allesblinkt/riverbed-control/z-module/z-axis-signals.md

e# Input Signal Connectors

## Stepper Z

Pul
Dir
Limit
Gnd

## Stepper A

Pul
Dir
Limit
Gnd

## Supply

24V
GND

## Grip/Sense

VacGoc
VacEject
VacSense

Light
Gnd
5V

# Output Signal Connectors

## LED

LED+
LED-

## Limits
La
Lb
Gnd

## Stepper Z

MA+
MA-
MB+
MB-

## Stepper A

MA+
MA-
MB+
MB-

## Vacuum

BN = Switch Vacuum generation
WH = Switch Ejector pulse
BK = Sense PNP 
dazwischen Rl (Load)
BU = GND

3
31

2
6

2
3
4
4
5

4pcs with 4
2pcs with 3
1pcs with 2
1pcs with 5
1pcs with 6

http://www.reichelt.de/Wannenstecker/AKL-182-04/3/index.html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

Relay?

PFET?
FET Switching
Voltage divider
Vacuum level
PNP

BN = Switch Vacuum generation
WH = Switch Ejector pulse
BK = Sense PNP 
between those is Rl (Load)
BU = GND

# Relais

LED out
Pulse Out
Vac Out
Vac In
