allesblinkt/riverbed-control/z-module-pcb/fab/DOC.md

0.5 mm bit

25000 rpm for all tools
Feed see pcb2gcode commands...\

 pcb2gcode --metric --back z-module-pcb-B.Cu.gbr --zwork -0.1 --zsafe 1.0 --mill-feed 100 --offset 0.25 --zchange 2.0 --mill-speed 6000 --mirror-absolute

Holes with 0.7 mm drill and 1 mm endmill. 

Contour with 1.0 mm endmill. Feed 800
