allesblinkt/riverbed-control/z-module-pcb/fab/z-module-pinout.pdf

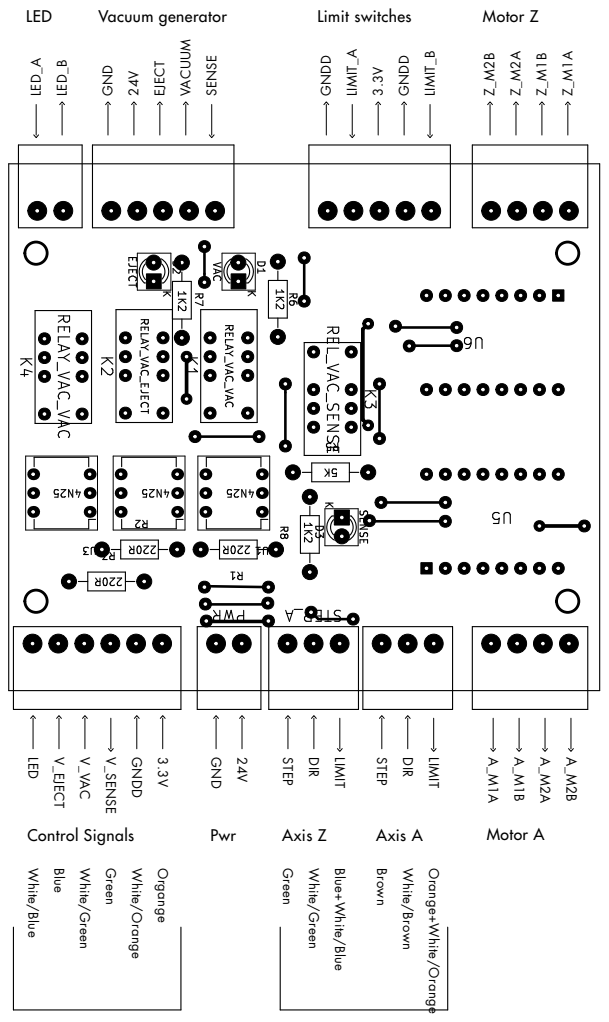
[picture p1: page 1]
LED_A; LED; Vacuum generator; Limit switches; Motor Z LED_B; GND 24V EJECT; VACUUM SENSE; GNDD LIMIT_A 3.3V GNDD LIMIT_B; Z_M²B; Z_M²A Z_M¹B; Control Signals; Motor A LED V_EJECT; V_VAC V_SENSE; GNDD 3.3V White/Blue; Blue; White/Green; Green; White/Orange; Organge; Pwr GND; Axis Z STEP; DIR; LIMIT; Axis A STEP; Brown; White/Brown

Blue+White/Blue

Orange+White/Orange
