allesblinkt/riverbed-control/z-module-pcb/z-module-pcb.pdf

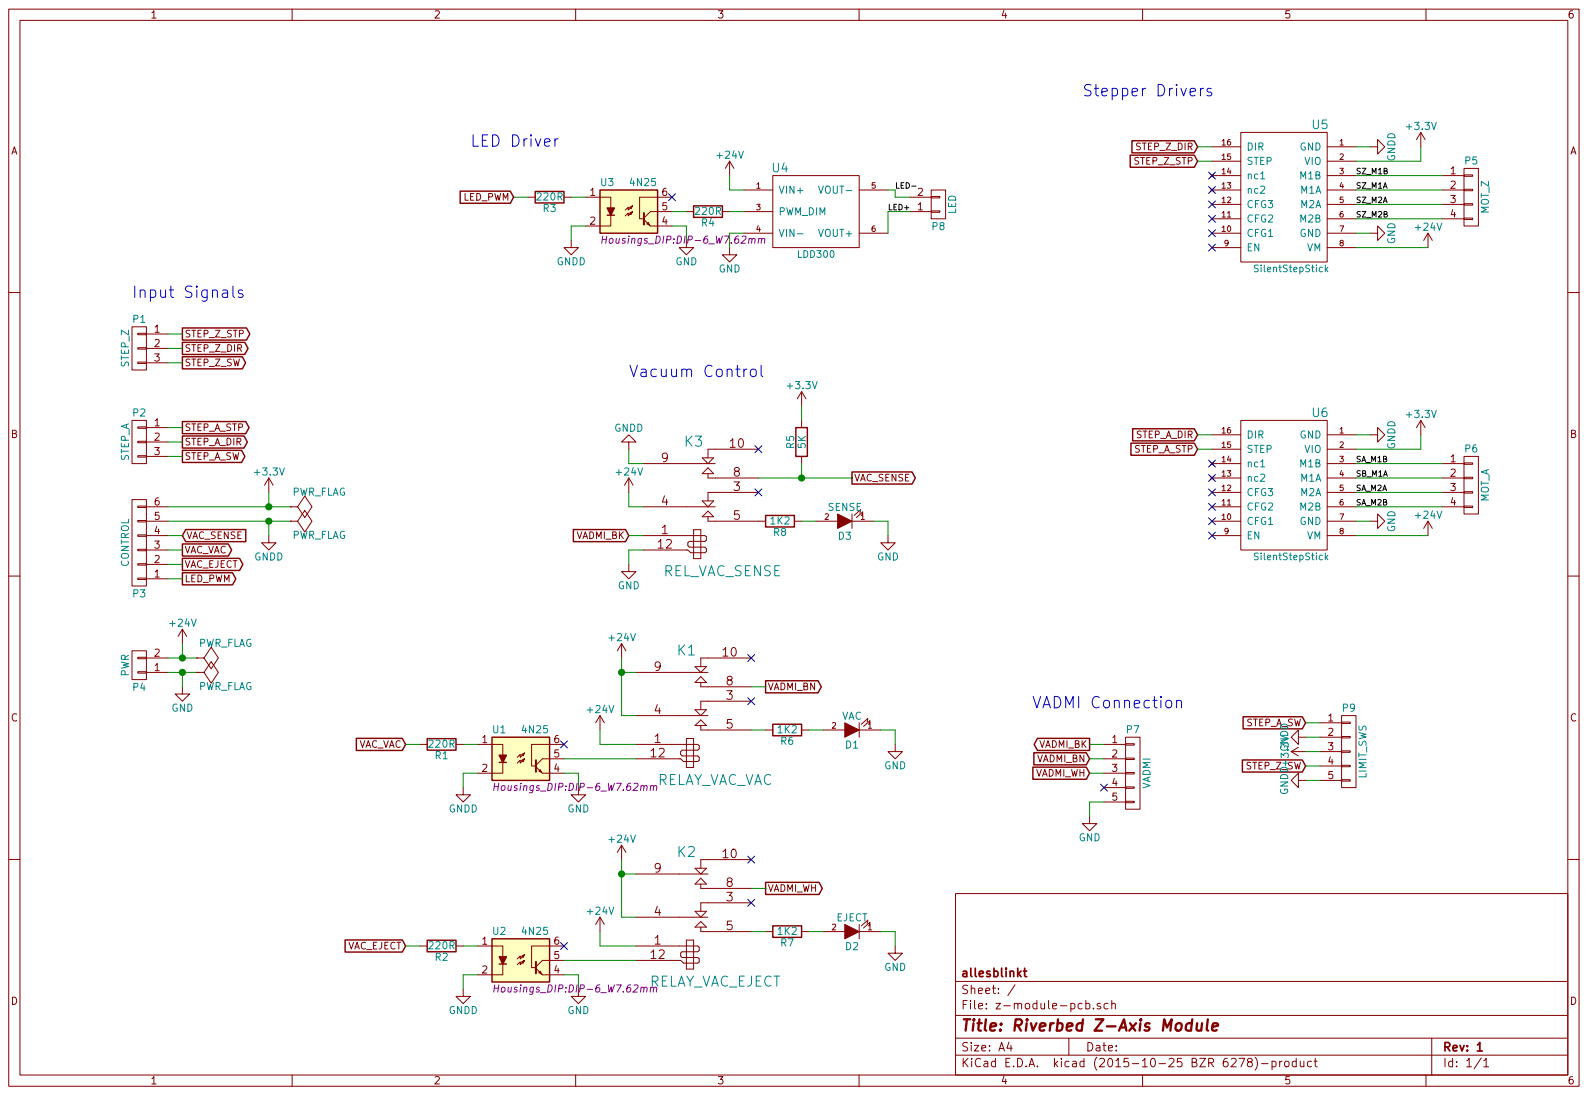
[picture p2: page 1]

SB_M1A 2
3 SA_M2A

File: z-module-pcb.sch Sheet: / allesblinkt

Id: 1/1 Title: Riverbed Z-Axis Module
