allesblinkt/riverbed-control/z-module-pcb/fab/z-module-assembly.pdf

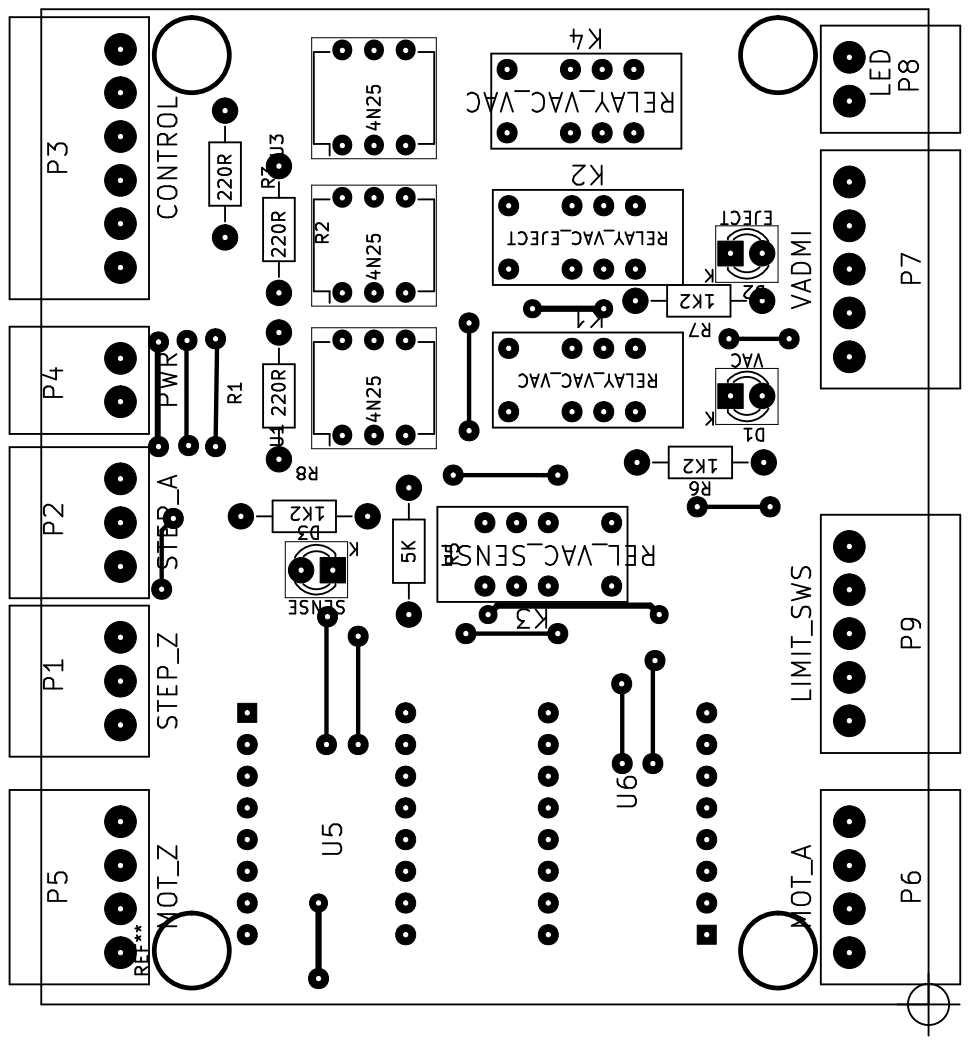
[picture p3: page 1]
