allesblinkt/riverbed-control/z-module-pcb-r2/z-module-pcb-r2.kicad_pcb

## KiCad design z-module-pcb-r2/z-module-pcb-r2.kicad_pcb (2017-08-10)

Schematic: z-module-pcb-r2.sch

Parts:
C1: 50u; CP_Radial_D7.5mm_P2.50mm
C2, C3, C4, C6, C7: 100n; C_0805
C5, C8: 20p; C_0805
D1: D_Schottky; D_SMA
D2: VacSense; LED_0805
D3: Status; LED_0805
D4: 5V; LED_0805
D5: 24V; LED_0805
D6, D8: BAT_46W; D_SOD-123
D7: Vacuum; LED_0805
D9: Eject; LED_0805
D10, D11, D12, D13, D14, D15, D16, D17, D18, D19, D20, D21, D22, D23, D24, D25, D26, D27, D28, D29: LED; LED_Osram_LW_E67C_LongPads_Thermal
F1: Rihanna; R_1812
F2: Drake; R_1812
HOLE1: 1; MountingHole_3mm
HOLE2: 2; MountingHole_3mm
HOLE3: 3; MountingHole_3mm
HOLE4: 4; MountingHole_3mm
HOLE5, HOLE6, HOLE7, HOLE8, HOLE9, HOLE10, HOLE11, HOLE12: CONN_01X01; MountingHole_2.2mm_M2
HOLE13, HOLE14: CONN_01X01; MountingHole_2.5mm
MB1, MB2, MB3, MB4, MB5, MB6, MB7, MB8, MB9, MB10, MB11, MB12, MB13, MB14, MB15, MB16, MB17, MB18, MB19, MB20: CONN_01X01; Mousebites_5_5mm_0-5mm
P1: Power; Molex_Microfit3_Header_02x02_Straight_43045-0428
P2: X1; RJ45_8-Vertical
P3: X2; RJ45_8-Vertical
P4: ISP; Pin_Header_Straight_2x03_Pitch2.54mm
P5: Z; Molex_Spox_board_4pin
P6: Vacuum; Molex_Microfit3_Header_02x04_Straight_43045-0828
P7: E; Molex_Spox_board_4pin
P8: HomeZ; Molex_Spox_board_3pin
P9: HomeE; Molex_Spox_board_3pin
P10, P18: Light; 0-188275-4_SMD_12-pin_female
P11, P12, P13, P14: 24V; Molex_PicoBlade_53048-0210_02x1.25mm_Angled
P15: 1; Molex_PicoBlade_53047-0210_02x1.25mm_Straight
P16: 2; Molex_PicoBlade_53047-0210_02x1.25mm_Straight
P17: 3; Molex_PicoBlade_53047-0210_02x1.25mm_Straight
P19: 4; Molex_PicoBlade_53047-0210_02x1.25mm_Straight
P20: 5; Molex_PicoBlade_53047-0210_02x1.25mm_Straight
P21: 6; Molex_PicoBlade_53047-0210_02x1.25mm_Straight
Q1, Q2, Q3, Q4, Q5, Q6, Q7, Q8: TSM3404_GSD; SOT-23
R1, R3, R5, R7, R9, R11, R13, R15, R17: 1K; R_0805
R2, R4, R6, R8, R10, R12, R14, R16, R18: *; R_0805
R19, R24, R26, R28, R29, R30, R31, R32, R33: 1K5; R_0805
R20, R21: 300R; R_0805
R22, R25, R27: 2K0; R_0805
R23: 10K; R_0805
R34, R35, R36, R37, R38, R39, R40, R41: 3K3; R_1206
U1: 74HC14; SOIC-14_3.9x8.7mm_Pitch1.27mm
U2, U4, U6: TLP281-4; SOIC-16_3.9x9.9mm_Pitch1.27mm
U3: 7805SR; TO-220
U5: 74HC04; SOIC-14_3.9x8.7mm_Pitch1.27mm
U7: ATMEGA328-AU; TQFP-32_7x7mm_Pitch0.8mm
Y1: Crystal_GND24; Crystal_SMD_3225-4pin_3.2x2.5mm

Connections:
+5V: C2.2, C3.2, C6.2, C7.2, F1.1, P3.8, P4.2, P8.1, P9.1, R1.1, R3.1, R5.1, R7.1, R9.1, R11.1, R13.1, R15.1, R17.1, R21.1, R23.2, U1.14 (VCC), U5.14 (VCC), U7.4 (VCC), U7.6 (VCC), U7.18 (AVCC); also elsewhere on the board
+24V: C1.1, D1.1 (K), D6.1 (K), D7.2 (A), D8.1 (K), D9.2 (A), P6.1, P6.2, P6.3, P10.2, P10.4, P10.6, P10.8, P10.10, P10.12, R22.1, U3.1 (IN); also elsewhere on the board
+28V: P15.1, P16.1, P17.1, P18.2, P18.4, P18.6, P18.8, P18.10, P18.12, P19.1, P20.1, P21.1
/AxisDriver1/M_1A: P5.3; also elsewhere on the board
/AxisDriver1/M_1B: P5.4; also elsewhere on the board
/AxisDriver1/M_2A: P5.2; also elsewhere on the board
/AxisDriver1/M_2B: P5.1; also elsewhere on the board
/AxisDriver2/M_1A: P7.3; also elsewhere on the board
/AxisDriver2/M_1B: P7.4; also elsewhere on the board
/AxisDriver2/M_2A: P7.2; also elsewhere on the board
/AxisDriver2/M_2B: P7.1; also elsewhere on the board
/CONTROL_COMM: P3.4, U4.5, U4.7, U6.1
/E_COMM: P2.8, U2.7, U4.1, U4.3
/E_DIR: U1.4; also elsewhere on the board
/E_DIR_IN: P2.6, R10.1
/E_EN: U1.2; also elsewhere on the board
/E_EN_IN: P2.7, R12.1
/E_HOME_OUT: P3.6, P9.2
/E_STEP: U1.6; also elsewhere on the board
/E_STEP_IN: P2.5, R8.1
/LED_1: P10.1, Q8.3 (D)
/LED_2: P10.3, Q7.3 (D)
/LED_3: P10.5, Q6.3 (D)
/LED_4: P10.7, Q5.3 (D)
/LED_5: P10.9, Q4.3 (D)
/LED_6: P10.11, Q3.3 (D)
/LED_A_A: P11.1, R34.2
/LED_A_K: D14.1 (K), P11.2
/LED_BO_1: P15.2, P18.1
/LED_BO_2: P16.2, P18.3
/LED_BO_3: P17.2, P18.5
/LED_BO_4: P18.7, P19.2
/LED_BO_5: P18.9, P20.2
/LED_BO_6: P18.11, P21.2
/LED_B_A: P12.1, R36.2
/LED_B_K: D19.1 (K), P12.2
/LED_C_A: P13.1, R38.2
/LED_C_K: D24.1 (K), P13.2
/LED_D_A: P14.1, R40.2
/LED_D_K: D29.1 (K), P14.2
/LIGHT_CTRL: U5.6, U7.32 ((PCINT18/INT0)PD2)
/LIGHT_CTRL_IN: P3.3, R18.1
/MISO: P4.1, U7.16 ((PCINT4/MISO)PB4)
/MOSI: P4.4, Q4.1 (G), R29.2, U7.15 ((PCINT3/OC2A/MOSI)PB3)
/PWM_LED_1: Q8.1 (G), R33.1, U7.1 ((PCINT19/OC2B/INT1)PD3)
/PWM_LED_2: Q7.1 (G), R32.1, U7.9 ((PCINT21/OC0B/T1)PD5)
/PWM_LED_3: Q6.1 (G), R31.1, U7.13 ((PCINT1/OC1A)PB1)
/PWM_LED_4: Q5.1 (G), R30.1, U7.14 ((PCINT2/OC1B/~SS~)PB2)
/PWM_LED_6: Q3.1 (G), R28.2, U7.10 ((PCINT22/OC0A/AIN0)PD6)
/RST: C4.2, P4.5, R23.1, U7.29 ((PCINT14/~RESET~)PC6)
/SCK: P4.3, U7.17 ((PCINT5/SCK)PB5)
/STATUSLED_1: R20.1, U7.12 ((PCINT0/CLKO/ICP1)PB0)
/VAC_AUX_AUX: P6.8
/VAC_BLACK_SENSE: D2.2 (A), P6.7
/VAC_BROWN_VAC: D8.2 (A), P6.6, Q2.3 (D), R25.1
/VAC_EJECT: Q1.1 (G), R24.1, U5.4
/VAC_EJECT_IN: P3.2, R16.1
/VAC_ON_IN: P3.1, R14.1
/VAC_SENSE_OUT: P3.7, U6.12
/VAC_VAC: Q2.1 (G), R26.1, U5.2
/VAC_WHITE_EJECT: D6.2 (A), P6.5, Q1.3 (D), R27.1
/XTAL1: C5.1, U7.8 ((PCINT7/XTAL2/TOSC2)PB7), Y1.1
/XTAL2: C8.1, U7.7 ((PCINT6/XTAL1/TOSC1)PB6), Y1.3
/Z_COMM: P2.4, U2.1, U2.3, U2.5
/Z_DIR: U1.10; also elsewhere on the board
/Z_DIR_IN: P2.2, R4.1
/Z_EN: U1.8; also elsewhere on the board
/Z_EN_IN: P2.3, R6.1
/Z_HOME_OUT: P3.5, P8.2
/Z_STEP: U1.12; also elsewhere on the board
/Z_STEP_IN: P2.1, R2.1
GND: C1.2, C2.1, C3.1, C4.1, C5.2, C6.1, C7.1, C8.2, D3.1 (K), D4.1 (K), D5.1 (K), P1.2, P1.4, P2.9, P3.9, P4.6, P6.4, P8.3, P9.3, Q1.2 (S), Q2.2 (S), Q3.2 (S), Q4.2 (S), Q5.2 (S), Q6.2 (S), Q7.2 (S), Q8.2 (S), R24.2, R26.2, R28.1, R29.1, R30.2, R31.2, R32.2, R33.2, U1.7 (GND), U2.9, U2.11, U2.13, U2.15, U3.2 (GND), U4.9, U4.11, U4.13, U4.15, U5.7 (GND), U6.6, U6.11, U6.15, U7.3 (GND), U7.5 (GND), U7.21 (GND), Y1.2, Y1.4; also elsewhere on the board
unnamed: D1.2 (A), F2.1
unnamed: D2.1 (K), R19.1
unnamed: D3.2 (A), R20.2
unnamed: D4.2 (A), R21.2
unnamed: D5.2 (A), R22.2
unnamed: D7.1 (K), R25.2
unnamed: D9.1 (K), R27.2
unnamed: D10.1 (K), D11.2 (A)
unnamed: D10.2 (A), R35.1
unnamed: D11.1 (K), D12.2 (A)
unnamed: D12.1 (K), D13.2 (A)
unnamed: D13.1 (K), D14.2 (A)
unnamed: D15.1 (K), D16.2 (A)
unnamed: D15.2 (A), R37.1
unnamed: D16.1 (K), D17.2 (A)
unnamed: D17.1 (K), D18.2 (A)
unnamed: D18.1 (K), D19.2 (A)
unnamed: D20.1 (K), D21.2 (A)
unnamed: D20.2 (A), R39.1
unnamed: D21.1 (K), D22.2 (A)
unnamed: D22.1 (K), D23.2 (A)
unnamed: D23.1 (K), D24.2 (A)
unnamed: D25.1 (K), D26.2 (A)
unnamed: D25.2 (A), R41.1
unnamed: D26.1 (K), D27.2 (A)
unnamed: D27.1 (K), D28.2 (A)
unnamed: D28.1 (K), D29.2 (A)
unnamed: F1.2, U3.3 (OUT)
unnamed: F2.2, P1.1, P1.3
unnamed: R1.2, U1.13, U2.16
unnamed: R2.2, U2.2
unnamed: R3.2, U1.11, U2.14
unnamed: R4.2, U2.4
unnamed: R5.2, U1.9, U2.12
unnamed: R6.2, U2.6
unnamed: R7.2, U1.5, U2.10
unnamed: R8.2, U2.8
unnamed: R9.2, U1.3, U4.16
unnamed: R10.2, U4.2
unnamed: R11.2, U1.1, U4.14
unnamed: R12.2, U4.4
unnamed: R13.2, U4.12, U5.1
unnamed: R14.2, U4.6
unnamed: R15.2, U4.10, U5.3
unnamed: R16.2, U4.8
unnamed: R17.2, U5.5, U6.16
unnamed: R18.2, U6.2
unnamed: R19.2, U6.5
unnamed: R34.1, R35.2
unnamed: R36.1, R37.2
unnamed: R38.1, R39.2
unnamed: R40.1, R41.2

Notes on the sheet:
Power Input
Status LEDs
Power LEDs
Holes
Motor Drivers
Processor
Switch Inputs
5 V Reg
* = 270 R @ 5V

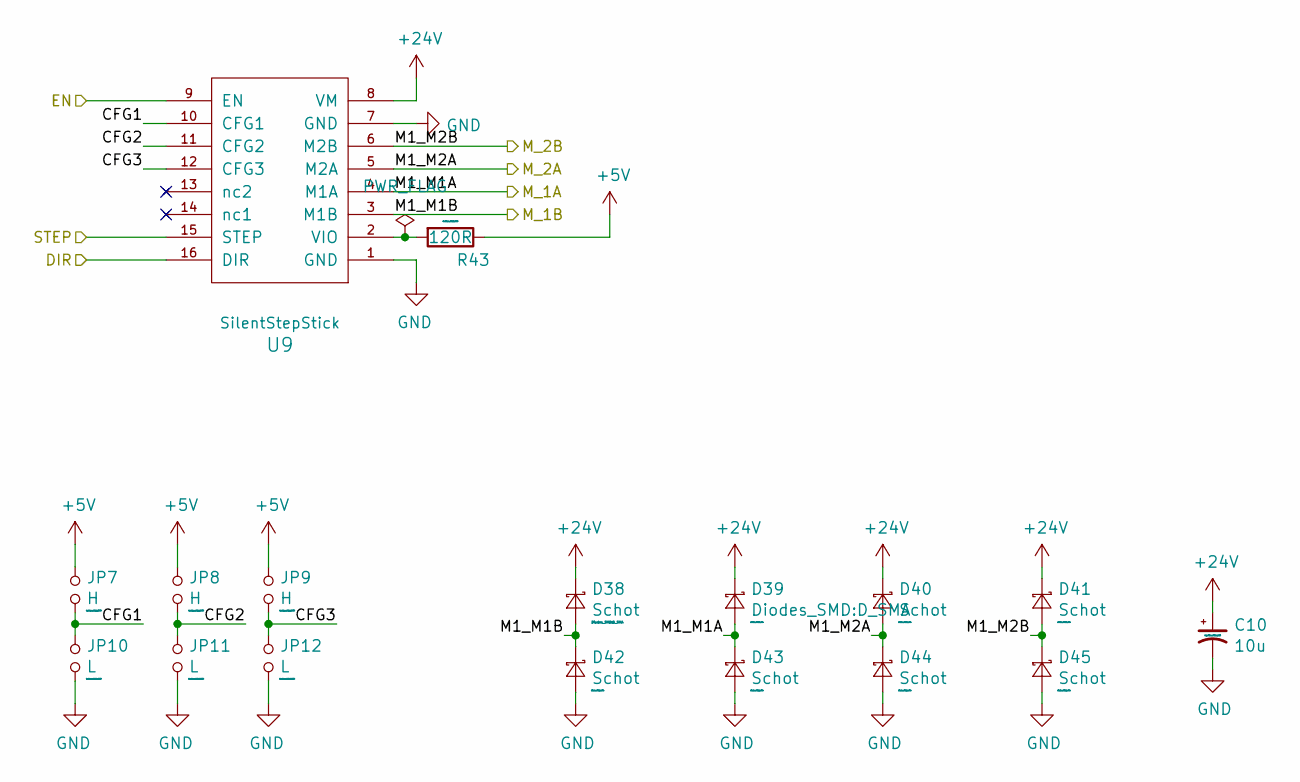
[picture p4: schematic axis_driver.sch]

Parts:
C9: 10u; C_1210
D30, D32, D33, D34, D35, D36, D37: Schot; D_SMA
D31: Diodes_SMD:D_SMA; D_SMA
JP1, JP2, JP3: H; R_0805
JP4, JP5, JP6: L; R_0805
R42: 120R; R_0805
U8: SilentStepStick

Connections:
+5V: JP1.1, JP2.1, JP3.1, R42.1; also elsewhere on the board
+24V: C9.1, D30.1 (K), D31.1 (K), D32.1 (K), D33.1 (K), U8.8 (VM); also elsewhere on the board
/AxisDriver2/CFG1: JP1.2, JP4.1, U8.10 (CFG1)
/AxisDriver2/CFG2: JP2.2, JP5.1, U8.11 (CFG2)
/AxisDriver2/CFG3: JP3.2, JP6.1, U8.12 (CFG3)
/AxisDriver2/M_1A: D31.2 (A), D35.1 (K), U8.4 (M1A); also elsewhere on the board
/AxisDriver2/M_1B: D30.2 (A), D34.1 (K), U8.3 (M1B); also elsewhere on the board
/AxisDriver2/M_2A: D32.2 (A), D36.1 (K), U8.5 (M2A); also elsewhere on the board
/AxisDriver2/M_2B: D33.2 (A), D37.1 (K), U8.6 (M2B); also elsewhere on the board
/E_DIR: U8.16 (DIR); also elsewhere on the board
/E_EN: U8.9 (EN); also elsewhere on the board
/E_STEP: U8.15 (STEP); also elsewhere on the board
GND: C9.2, D34.2 (A), D35.2 (A), D36.2 (A), D37.2 (A), JP4.2, JP5.2, JP6.2, U8.1 (GND), U8.7 (GND); also elsewhere on the board
unnamed: R42.2, U8.2 (VIO)

Parts of its further copies:
C10: 10u; C_1210
D38, D40, D41, D42, D43, D44, D45: Schot; D_SMA
D39: Diodes_SMD:D_SMA; D_SMA
JP7, JP8, JP9: H; R_0805
JP10, JP11, JP12: L; R_0805
R43: 120R; R_0805
U9: SilentStepStick

Connections of its further copies:
+5V: JP7.1, JP8.1, JP9.1, R43.1; also elsewhere on the board
+24V: C10.1, D38.1 (K), D39.1 (K), D40.1 (K), D41.1 (K), U9.8 (VM); also elsewhere on the board
/AxisDriver1/CFG1: JP7.2, JP10.1, U9.10 (CFG1)
/AxisDriver1/CFG2: JP8.2, JP11.1, U9.11 (CFG2)
/AxisDriver1/CFG3: JP9.2, JP12.1, U9.12 (CFG3)
/AxisDriver1/M_1A: D39.2 (A), D43.1 (K), U9.4 (M1A); also elsewhere on the board
/AxisDriver1/M_1B: D38.2 (A), D42.1 (K), U9.3 (M1B); also elsewhere on the board
/AxisDriver1/M_2A: D40.2 (A), D44.1 (K), U9.5 (M2A); also elsewhere on the board
/AxisDriver1/M_2B: D41.2 (A), D45.1 (K), U9.6 (M2B); also elsewhere on the board
/Z_DIR: U9.16 (DIR); also elsewhere on the board
/Z_EN: U9.9 (EN); also elsewhere on the board
/Z_STEP: U9.15 (STEP); also elsewhere on the board
GND: C10.2, D42.2 (A), D43.2 (A), D44.2 (A), D45.2 (A), JP10.2, JP11.2, JP12.2, U9.1 (GND), U9.7 (GND); also elsewhere on the board
unnamed: R43.2, U9.2 (VIO)

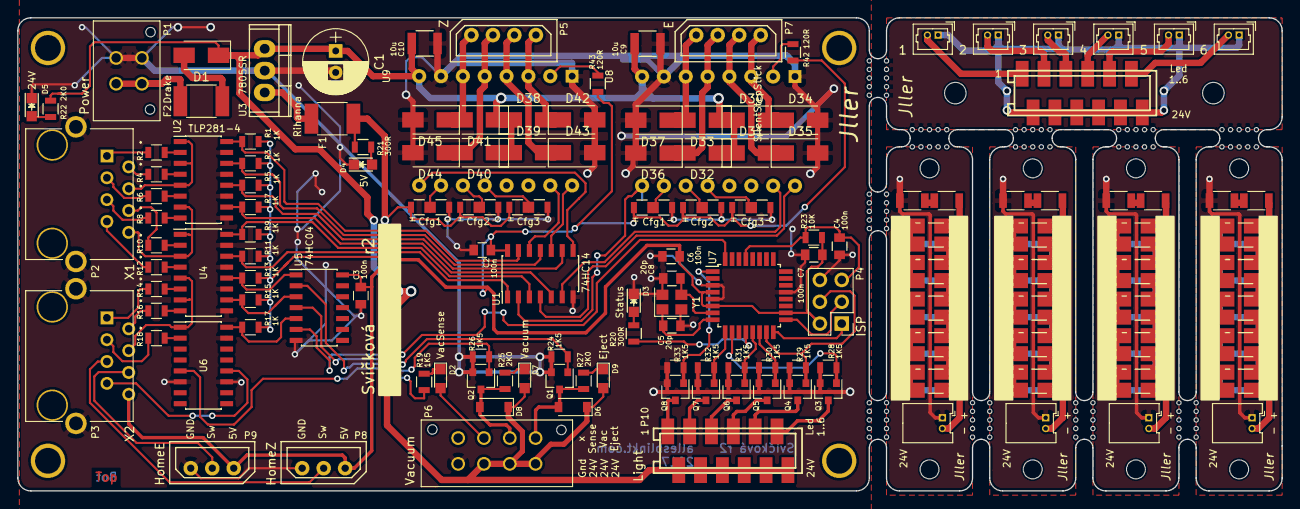
[picture p5: board z-module-pcb-r2.kicad_pcb from above]

Board: 2 copper layers, 147.0 x 55.0 mm, 185 parts (0 on the bottom side), 131 nets.
