allesblinkt/riverbed-control/z-module-pcb/z-module-pcb.kicad_pcb

## KiCad design z-module-pcb/z-module-pcb.kicad_pcb (2015-11-14)

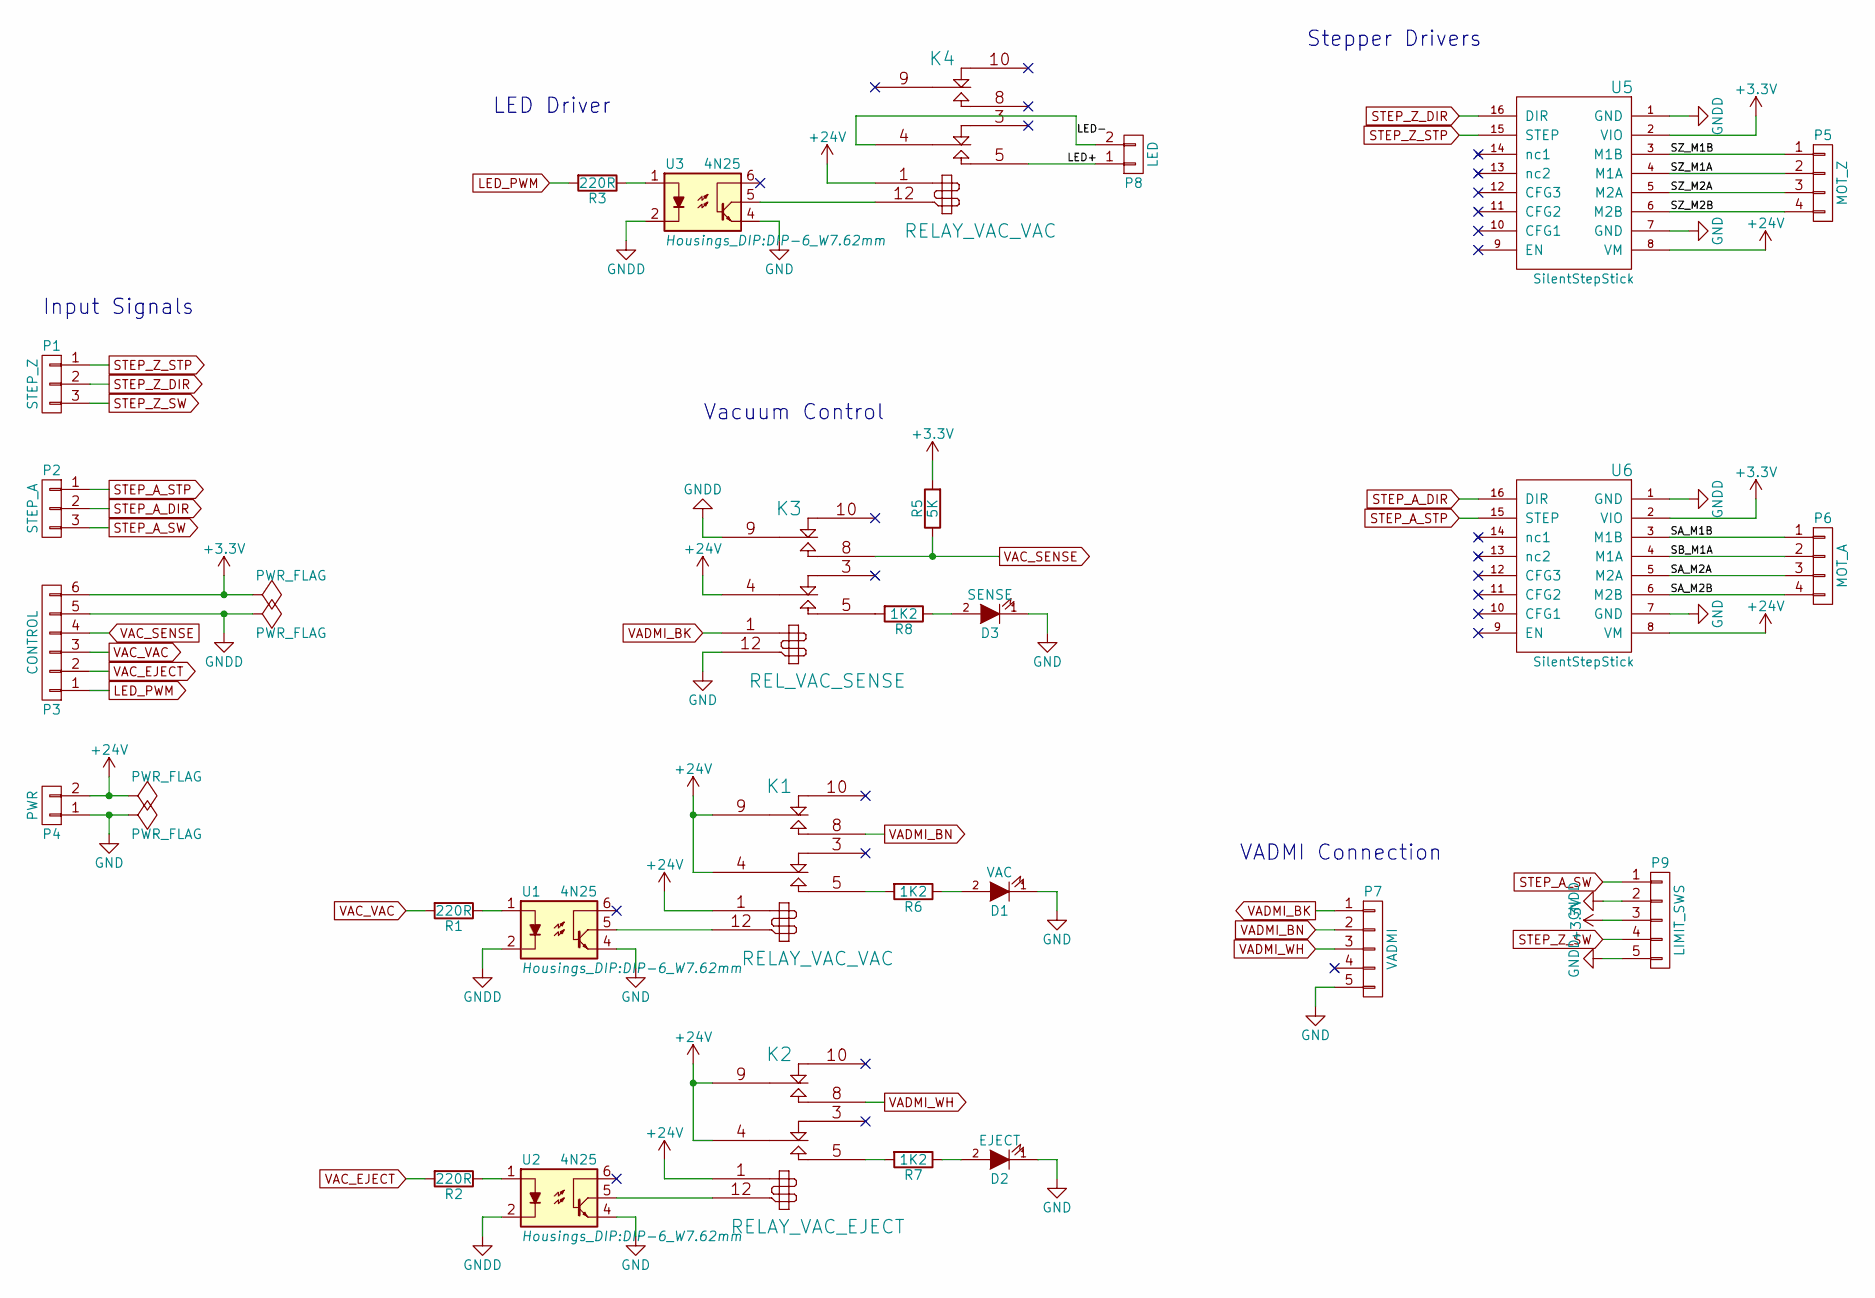
[picture p6: schematic z-module-pcb.sch, Riverbed Z-Axis Module]

Parts:
D1: VAC; LED-3MM
D2: EJECT; LED-3MM
D3: SENSE; LED-3MM
K1, K4: RELAY_VAC_VAC; AxicomRelay-V23079
K2: RELAY_VAC_EJECT; AxicomRelay-V23079
K3: REL_VAC_SENSE; AxicomRelay-V23079
P1: STEP_Z; AKL_182-03
P2: STEP_A; AKL_182-03
P3: CONTROL; AKL_182-06
P4: PWR; AKL_182-02
P5: MOT_Z; AKL_182-04
P6: MOT_A; AKL_182-04
P7: VADMI; AKL_182-05
P8: LED; AKL_182-02
P9: LIMIT_SWS; AKL_182-05
R1, R2, R3: 220R; Resistor_Horizontal_RM10mm
R5: 5K; Resistor_Horizontal_RM10mm
R6, R7, R8: 1K2; Resistor_Horizontal_RM10mm
U1, U2, U3: 4N25; DIP-6_W7.62mm
U5, U6: SilentStepStick

Connections:
+3V3: P3.6, P9.3, R5.2, U5.2 (VIO), U6.2 (VIO)
+24V: K1.1, K1.4, K1.9, K2.1, K2.4, K2.9, K3.4, K4.1, P4.2, U5.8 (VM), U6.8 (VM)
/LED+: K4.5, P8.1
/LED-: K4.4, P8.2
/SA_M1B: P6.1, U6.3 (M1B)
/SA_M2A: P6.3, U6.5 (M2A)
/SA_M2B: P6.4, U6.6 (M2B)
/SB_M1A: P6.2, U6.4 (M1A)
/SZ_M1A: P5.2, U5.4 (M1A)
/SZ_M1B: P5.1, U5.3 (M1B)
/SZ_M2A: P5.3, U5.5 (M2A)
/SZ_M2B: P5.4, U5.6 (M2B)
GND: D1.1 (K), D2.1 (K), D3.1 (K), K3.12, P4.1, P7.5, U1.4, U2.4, U3.4, U5.7 (GND), U6.7 (GND)
GNDD: K3.9, P3.5, P9.2, P9.5, U1.2, U2.2, U3.2, U5.1 (GND), U6.1 (GND)
LED_PWM: P3.1, R3.2
unnamed: D1.2 (A), R6.1
unnamed: D2.2 (A), R7.1
unnamed: D3.2 (A), R8.1
unnamed: K1.5, R6.2
unnamed: K1.12, U1.5
unnamed: K2.5, R7.2
unnamed: K2.12, U2.5
unnamed: K3.5, R8.2
unnamed: K4.12, U3.5
unnamed: R1.1, U1.1
unnamed: R2.1, U2.1
unnamed: R3.1, U3.1
STEP_A_DIR: P2.2, U6.16 (DIR)
STEP_A_STP: P2.1, U6.15 (STEP)
STEP_A_SW: P2.3, P9.1
STEP_Z_DIR: P1.2, U5.16 (DIR)
STEP_Z_STP: P1.1, U5.15 (STEP)
STEP_Z_SW: P1.3, P9.4
VAC_EJECT: P3.2, R2.2
VAC_SENSE: K3.8, P3.4, R5.1
VAC_VAC: P3.3, R1.2
VADMI_BK: K3.1, P7.1
VADMI_BN: K1.8, P7.2
VADMI_WH: K2.8, P7.3

Notes on the sheet:
Stepper Drivers
VADMI Connection
LED Driver
Vacuum Control
Input Signals

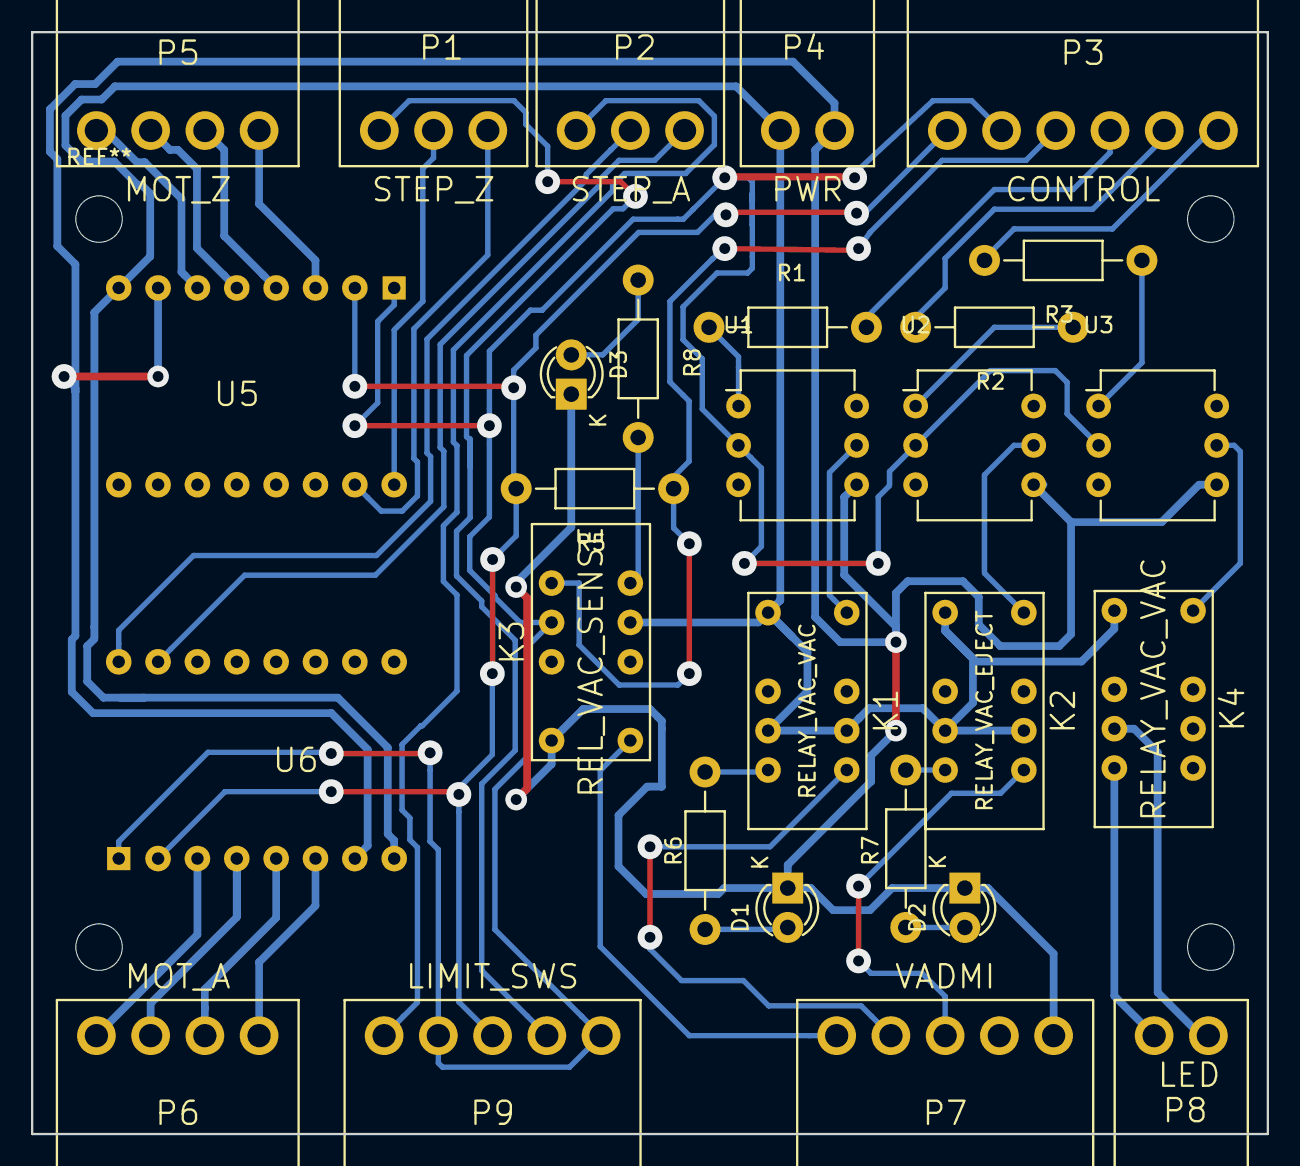
[picture p7: board z-module-pcb.kicad_pcb from above]

Board: 2 copper layers, 79.8 x 71.1 mm, 28 parts (0 on the bottom side), 39 nets.
