allesblinkt/riverbed-control/(commit log)

2015-11-09 Added notes for signals of Z-Axis
2015-11-09 Relay thoughts
2015-11-09 Ignoring some Kicad files
2015-11-09 PCB schematic and layout WiP. Libraries with custom components.
    [z-module-pcb.kicad_pcb, z-module-pcb.sch]
2015-11-10 Layout almost done. To be checked.
    [z-module-pcb.kicad_pcb, z-module-pcb.sch]
2015-11-10 Schematic PDF
2015-11-14 Finalized and cleaned design
    [z-module-pcb.kicad_pcb, z-module-pcb.sch]
2015-11-14 Fabrication files
    [z-module-pcb-B.Cu.gbr, z-module-pcb.drl]
2015-11-22 Added wiring thoughts
2017-08-10 Added footprints for new head board
2017-08-10 Added final project files for new head board
    [axis_driver.sch, z-module-pcb-r2.kicad_pcb, z-module-pcb-r2.sch]
2017-08-10 Added fab files as sent to elecrow
    [z-module-pcb-r2-B.Cu.gbr, z-module-pcb-r2-B.Mask.gbr, z-module-pcb-r2-Dwgs.User.gbr, z-module-pcb-r2-Edge.Cuts.gbr, z-module-pcb-r2-F.Cu.gbr, z-module-pcb-r2-F.Mask.gbr, z-module-pcb-r2-F.Paste.gbr, z-module-pcb-r2-F.SilkS.gbr]
